yixing312/Product_engineering_design_practice/README.md

# Product_engineering_design_practice

本项目用于产品工程化设计文档的组队公用文件交流

git路径在<https://github.com/yixing312/Product_engineering_design_practice>
