yixing312/Product_engineering_design_practice/model/README.md

# Readme

本文件夹用于存放模型文件

* `model_0` 是由 mzhgg 建立的，是整个产品设计的示意图。
