yixing312/Product_engineering_design_practice/model/model_1/MG995/egrane2latonpin.SLDPRT.SLDASM

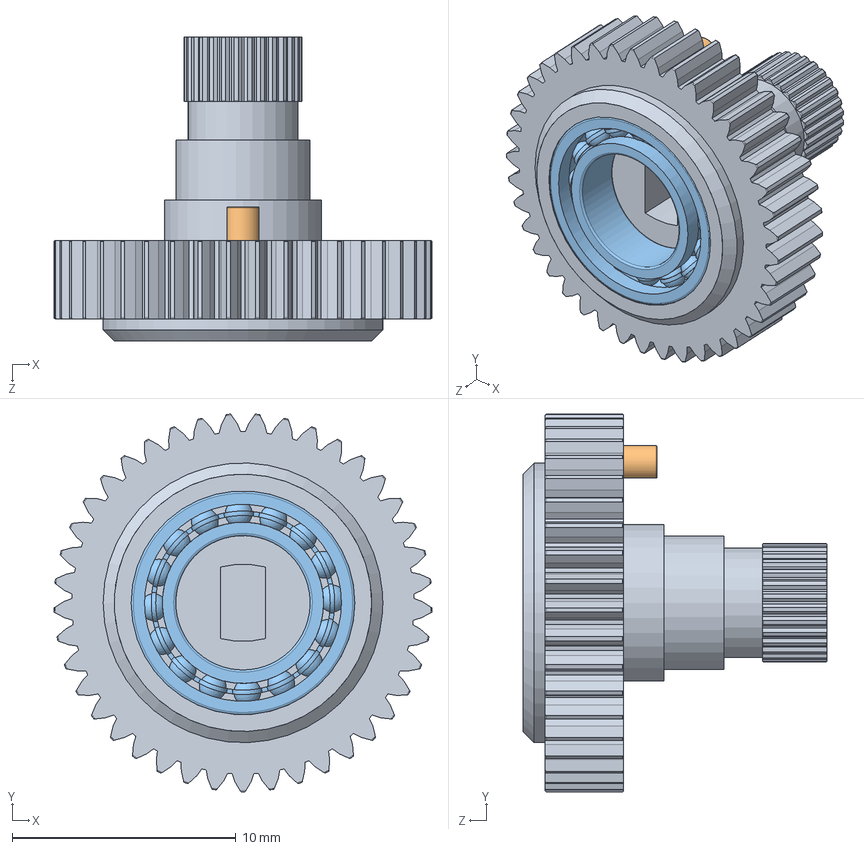
[picture p64: CAD file, 2024-06-03]
model/model_1/MG995/egrane2latonpin.SLDPRT.SLDASM
16.9 x 16.9 x 13.6 mm
otro
egrane2latonpin
radial ball bearing_68_am
