yixing312/Product_engineering_design_practice/model/model_0/MG995/egrane4aluminiolaton.SLDPRT.SLDASM

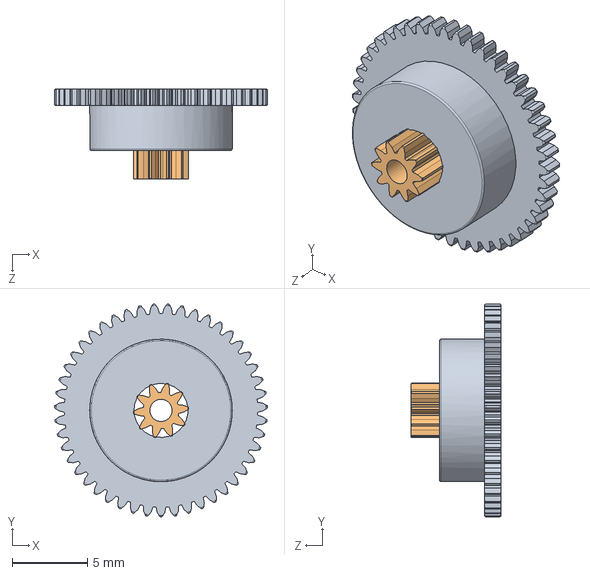
[picture p65: CAD file, 2024-05-30]
model/model_0/MG995/egrane4aluminiolaton.SLDPRT.SLDASM
14.2 x 14.2 x 6.00 mm
egrane4laton
egrane4aluminio
