yixing312/Product_engineering_design_practice/model/model_1/MG995/MG995.SLDASM

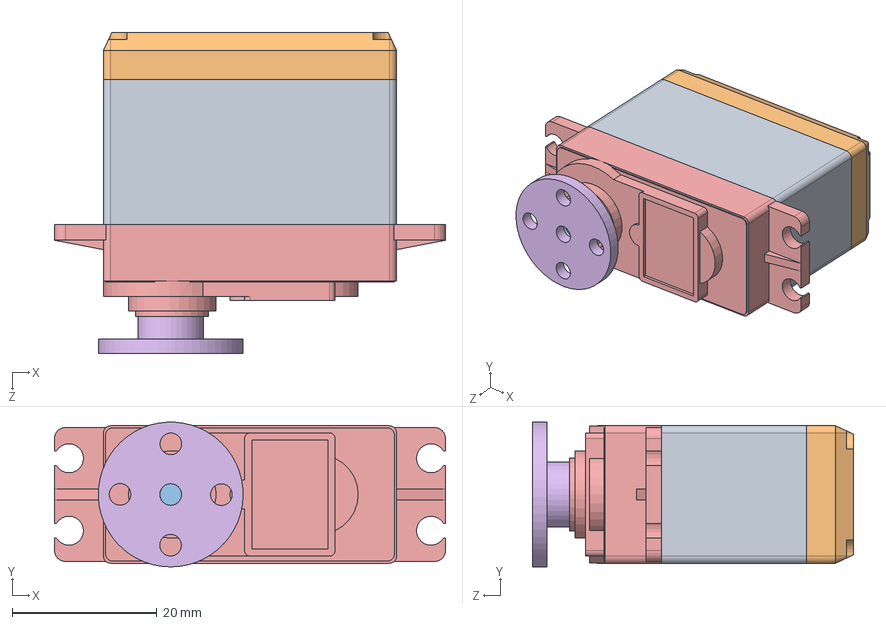
[picture p66: CAD file, 2024-06-03]
model/model_1/MG995/MG995.SLDASM
54.0 x 20.0 x 44.3 mm
centroservo
egrane3laton
egrane3aluminio
egrane4laton
egrane4aluminio
engrane2
pincorto
pinlargo
radial ball bearing_68_am x 2
baseservo
otro
egrane2latonpin
tapa servo
Bracket-Horn
