yixing312/Product_engineering_design_practice/model/model_0/MG995/egrane3aluminiolaton.SLDPRT.SLDASM

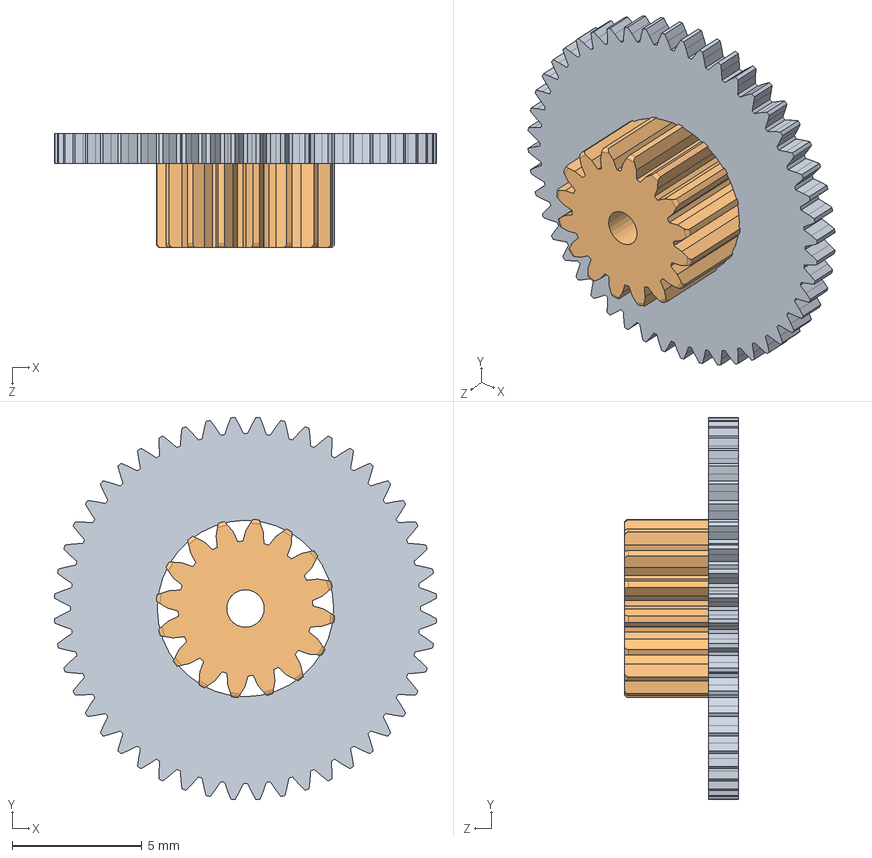
[picture p67: CAD file, 2024-05-30]
model/model_0/MG995/egrane3aluminiolaton.SLDPRT.SLDASM
14.7 x 14.7 x 4.40 mm
egrane3laton
egrane3aluminio
