yixing312/Product_engineering_design_practice/model/model_1/崭新的基座.SLDASM

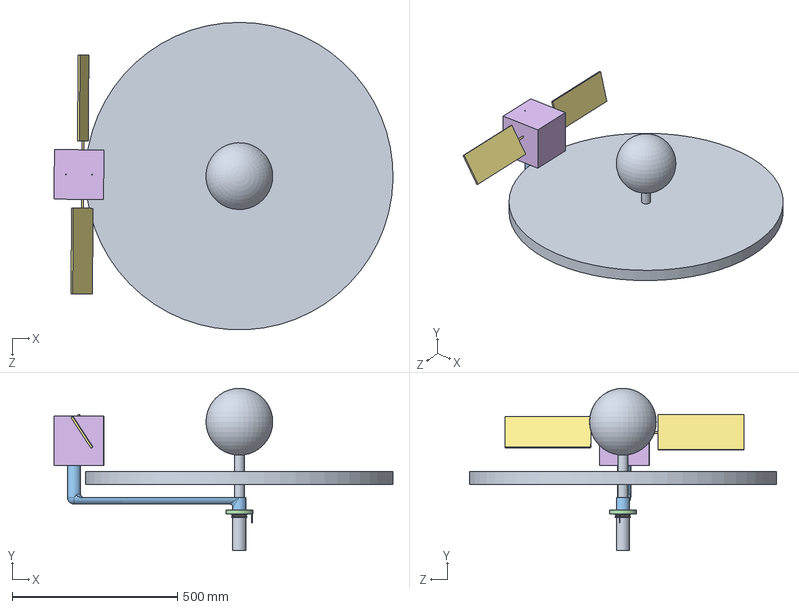
[picture p68: CAD file, 2024-06-03]
model/model_1/崭新的基座.SLDASM
1025.4 x 491.1 x 929.3 mm
地球和底座
thrust ball bearings gb
承载臂
导电滑环-假
卫星支架_舵机1连接件
centroservo
egrane3laton
egrane3aluminio
egrane4laton
egrane4aluminio
engrane2
pincorto
pinlargo
radial ball bearing_68_am x 2
baseservo
otro
egrane2latonpin
tapa servo
Bracket-Horn
舵机3_帆板
卫星本体_舵机支架3 x 2
卫星本体
帆板 x 2
