yixing312/Product_engineering_design_practice/model/model_1/MG995/tapa servorodamiento.SLDPRT.SLDASM

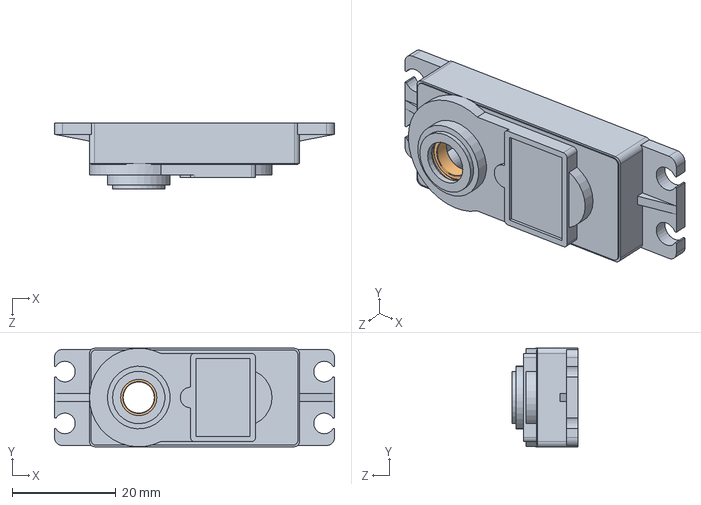
[picture p69: CAD file, 2024-05-30]
model/model_1/MG995/tapa servorodamiento.SLDPRT.SLDASM
54.0 x 19.0 x 12.8 mm
tapa servo
radial ball bearing_68_am
