yixing312/Product_engineering_design_practice/model/model_0/Assembly.SLDASM

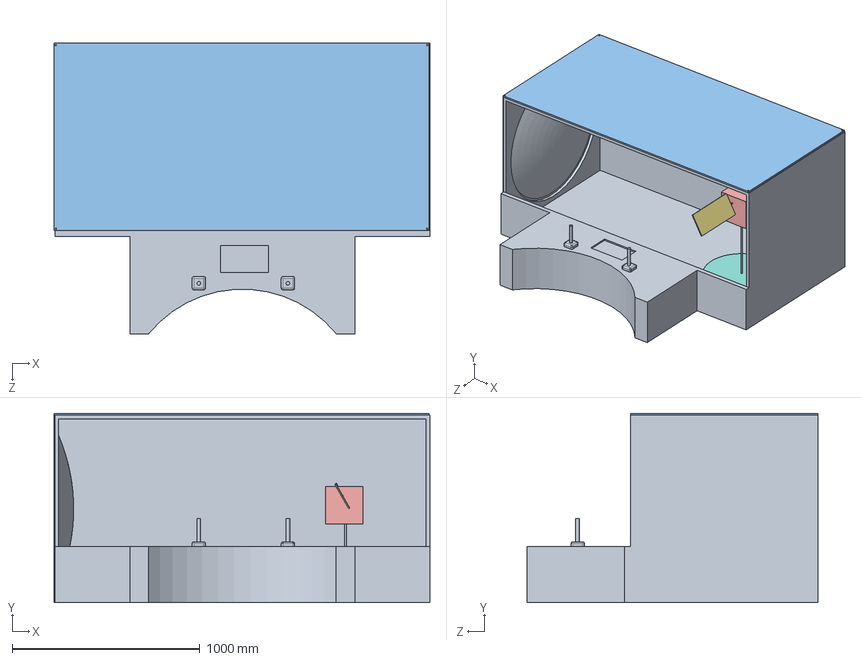
[picture p72: CAD file, 2024-05-30]
model/model_0/Assembly.SLDASM
2005.0 x 1010.0 x 1550.0 mm
centroservo x 3
egrane3laton x 3
egrane3aluminio x 3
egrane4laton x 3
egrane4aluminio x 3
engrane2 x 3
pincorto x 3
pinlargo x 3
radial ball bearing_68_am x 6
baseservo x 3
otro x 3
egrane2latonpin x 3
tapa servo x 3
Bracket-Horn x 3
卫星支架
卫星支架_舵机1连接件
卫星支架_舵机2
卫星支架_舵机3
舵机3_帆板
卫星本体
卫星本体_舵机支架3 x 2
帆板 x 2
light plat
plate
raspberrypi
