yixing312/Product_engineering_design_practice/model/model_0/MG995/egrane2latonpin.SLDPRT

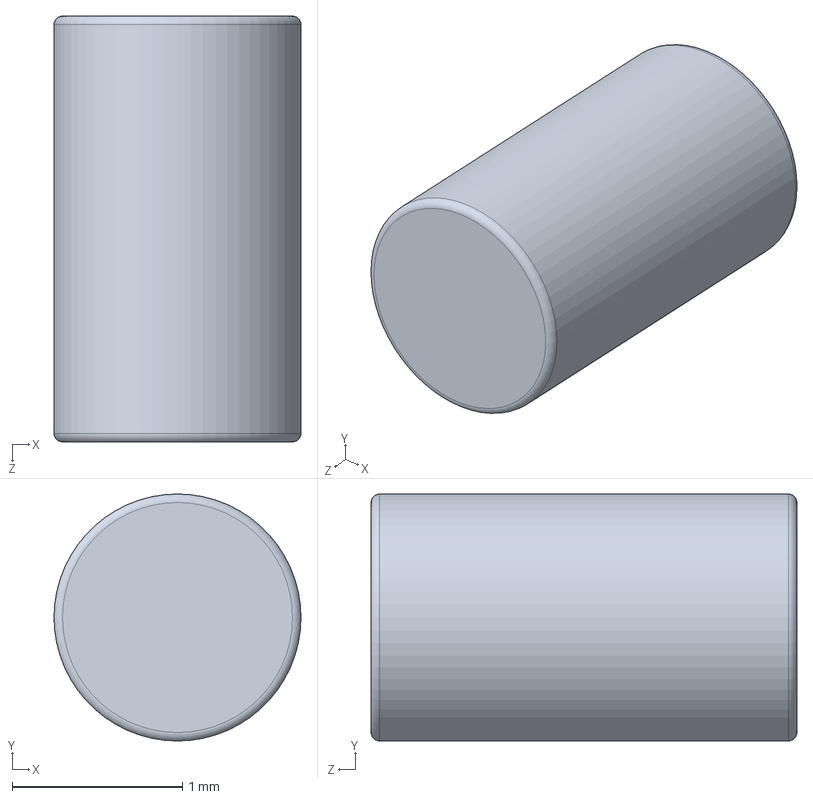
[picture p73: CAD file, 2024-05-30]
model/model_0/MG995/egrane2latonpin.SLDPRT
1.45 x 1.45 x 2.50 mm
