yixing312/Product_engineering_design_practice/model/model_1/承载臂.SLDPRT

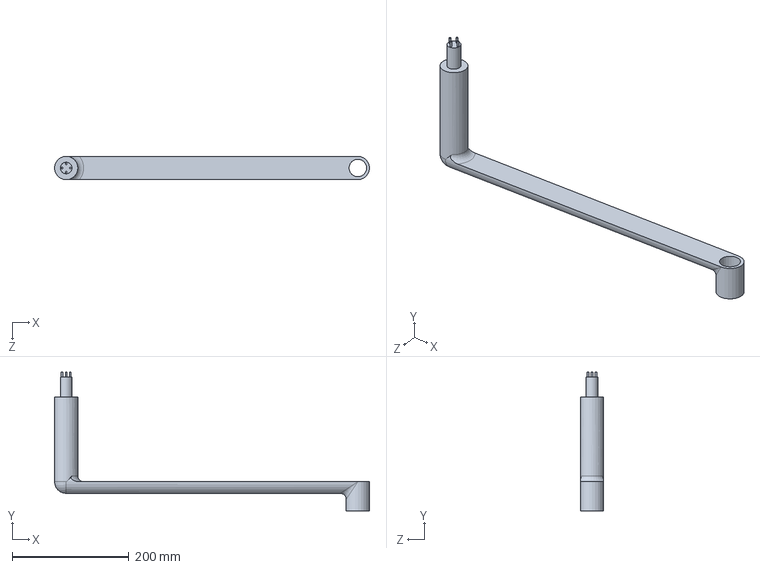
[picture p75: CAD file, 2024-06-03]
model/model_1/承载臂.SLDPRT
540.0 x 238.0 x 40.1 mm
