yixing312/Product_engineering_design_practice/model/model_0/light plat.SLDPRT

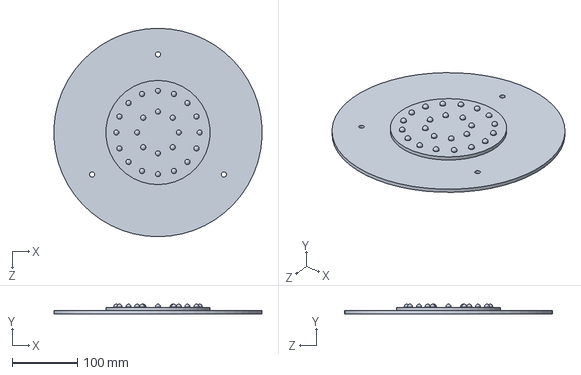
[picture p76: CAD file, 2024-05-30]
model/model_0/light plat.SLDPRT
319.5 x 15.0 x 320.0 mm
