yixing312/Product_engineering_design_practice/model/model_1/导电滑环-假.SLDPRT

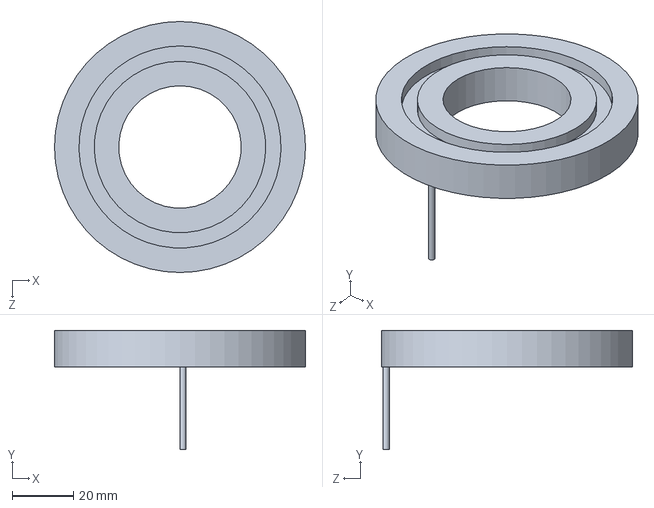
[picture p77: CAD file, 2024-06-03]
model/model_1/导电滑环-假.SLDPRT
82.0 x 39.0 x 82.0 mm
