yixing312/Product_engineering_design_practice/drawing/卫星部分.DXF

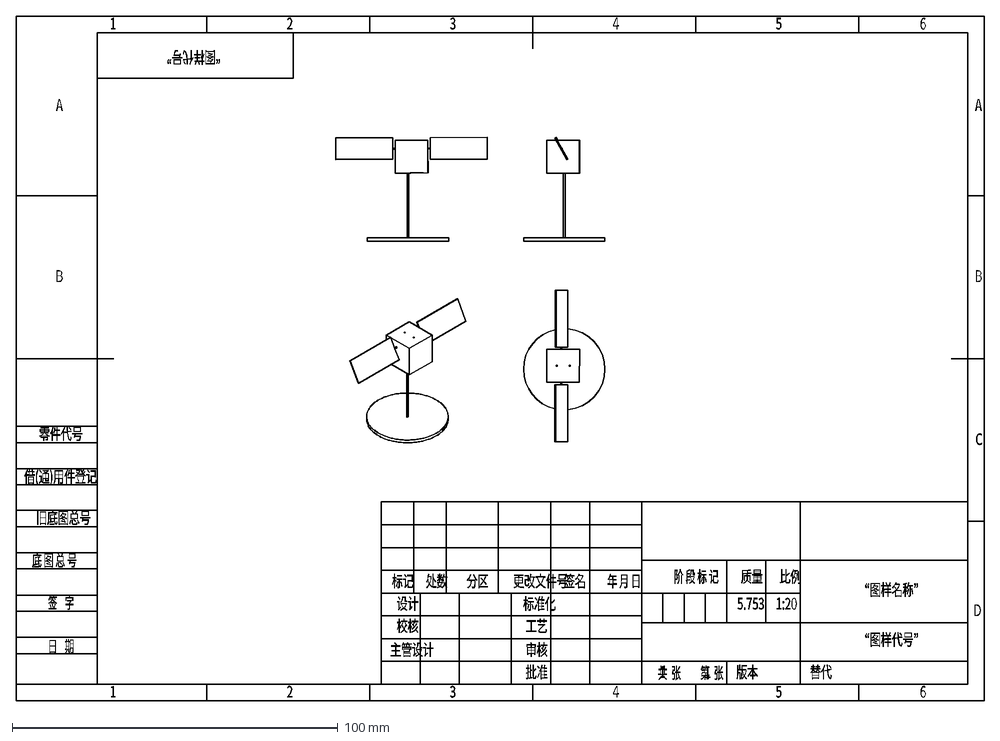
[picture p78: CAD file, 2024-05-31]
drawing/卫星部分.DXF
“图样代号”
替代
版本
审核
工艺
比例
质量
第 张
共 张
阶 段 标 记
批准
标准化
主管设计
年 月 日
签名
更改文件号
分区
处数
标记
设计
校核
零件代号
借(通)用件登记
旧底图总号
底 图 总 号
日 期
“图样名称”
5.753
1
1:20
B
A
D
C
签 字
2
5
4
3
6
