yixing312/Product_engineering_design_practice/model/model_0/舵机3_帆板.SLDPRT

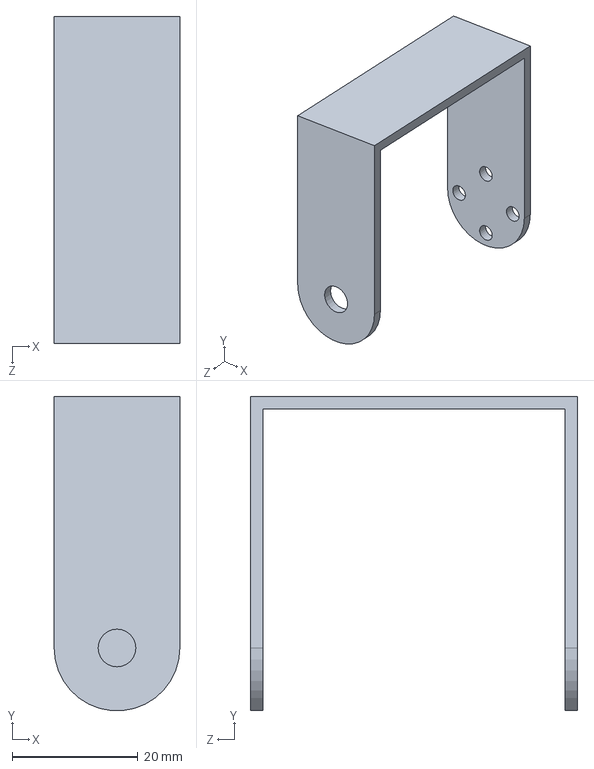
[picture p79: CAD file, 2024-05-30]
model/model_0/舵机3_帆板.SLDPRT
20.0 x 50.0 x 52.0 mm
