yixing312/Product_engineering_design_practice/model/model_1/MG995/pinlargo.SLDPRT

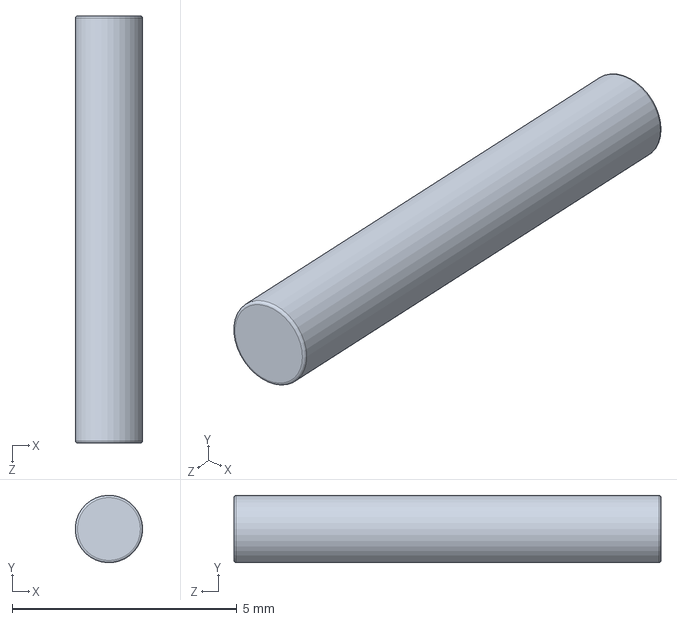
[picture p80: CAD file, 2024-05-30]
model/model_1/MG995/pinlargo.SLDPRT
1.50 x 1.50 x 9.50 mm
