yixing312/Product_engineering_design_practice/model/model_1/地球和底座.SLDPRT

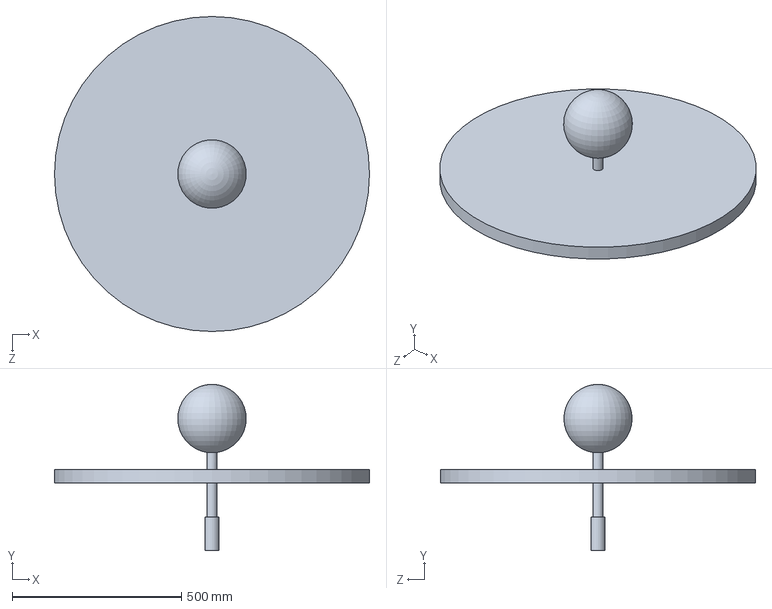
[picture p81: CAD file, 2024-06-03]
model/model_1/地球和底座.SLDPRT
930.0 x 491.1 x 930.0 mm
