yixing312/Product_engineering_design_practice/model/model_0/satellite.SLDPRT

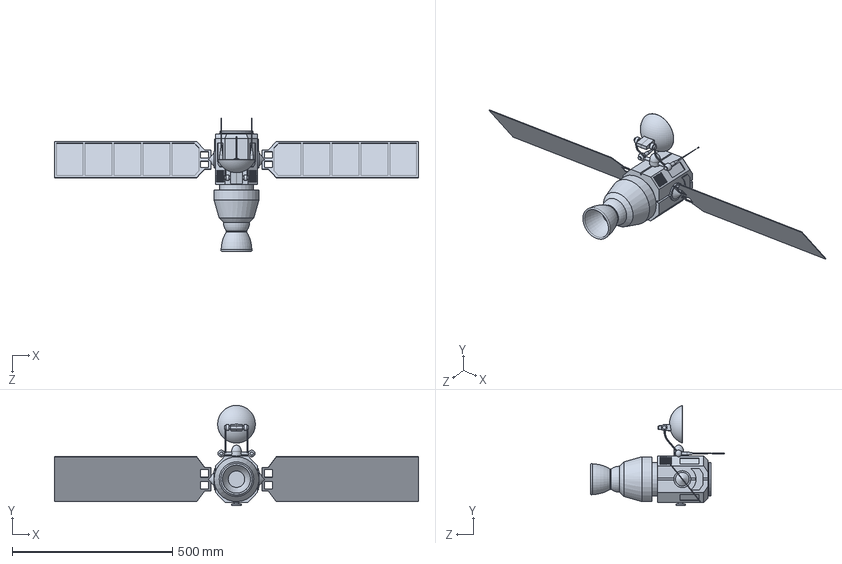
[picture p82: CAD file, 2024-05-30]
model/model_0/satellite.SLDPRT
1134.7 x 312.6 x 416.3 mm
