yixing312/Product_engineering_design_practice/model/model_1/MG995/egrane3aluminio.SLDPRT

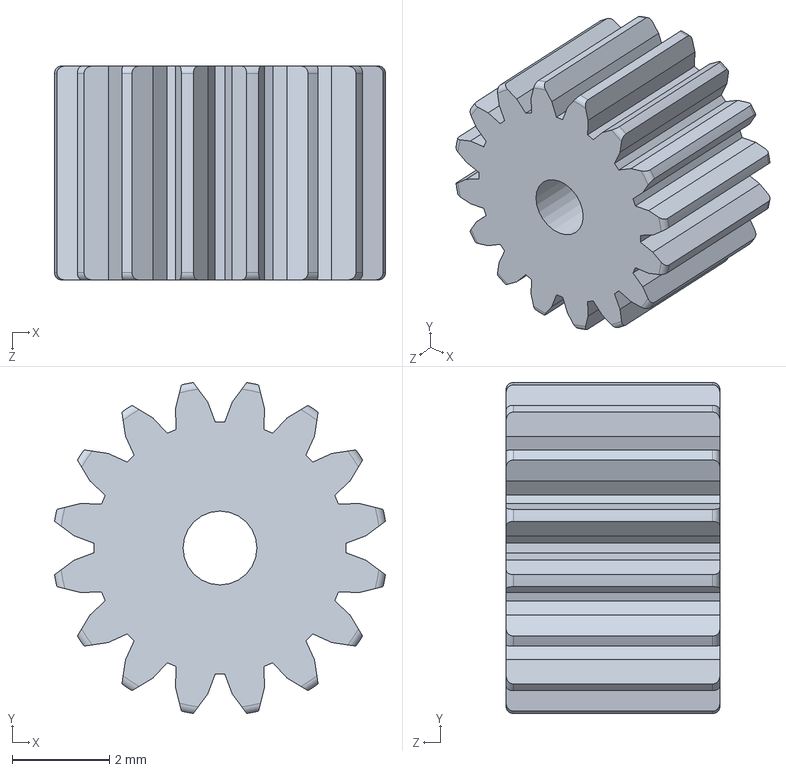
[picture p83: CAD file, 2024-05-30]
model/model_1/MG995/egrane3aluminio.SLDPRT
6.81 x 6.81 x 4.40 mm
