yixing312/Product_engineering_design_practice/model/model_1/帆板.SLDPRT

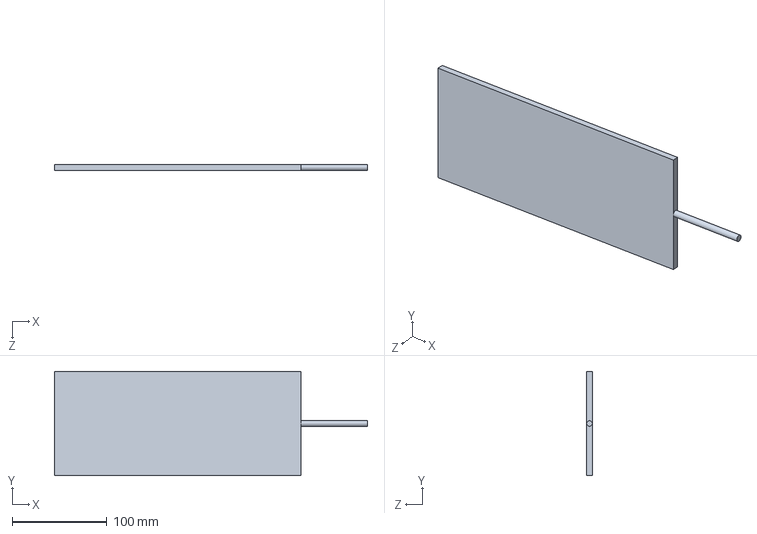
[picture p84: CAD file, 2024-06-03]
model/model_1/帆板.SLDPRT
330.0 x 110.0 x 6.00 mm
