yixing312/Product_engineering_design_practice/model/model_0/MG995/centroservo.SLDPRT

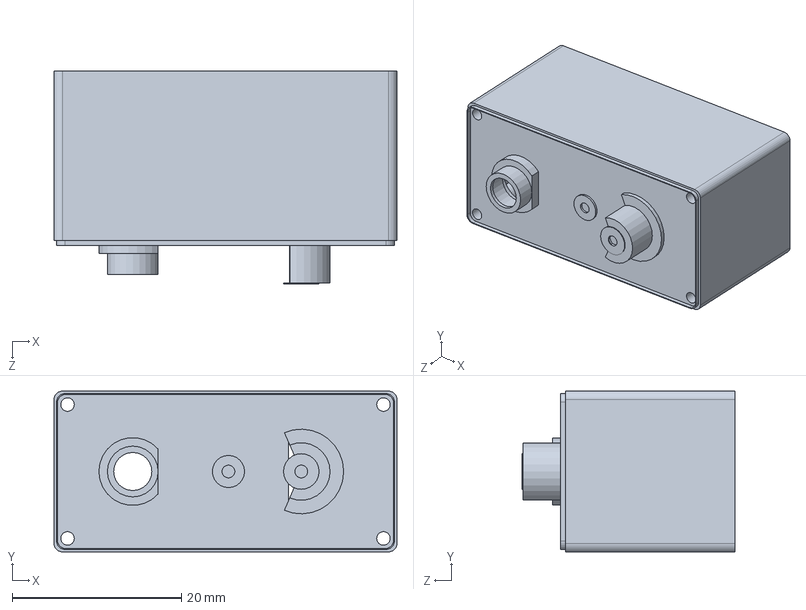
[picture p85: CAD file, 2024-05-30]
model/model_0/MG995/centroservo.SLDPRT
40.5 x 19.0 x 25.1 mm
