yixing312/Product_engineering_design_practice/model/model_0/卫星支架_舵机2.SLDPRT

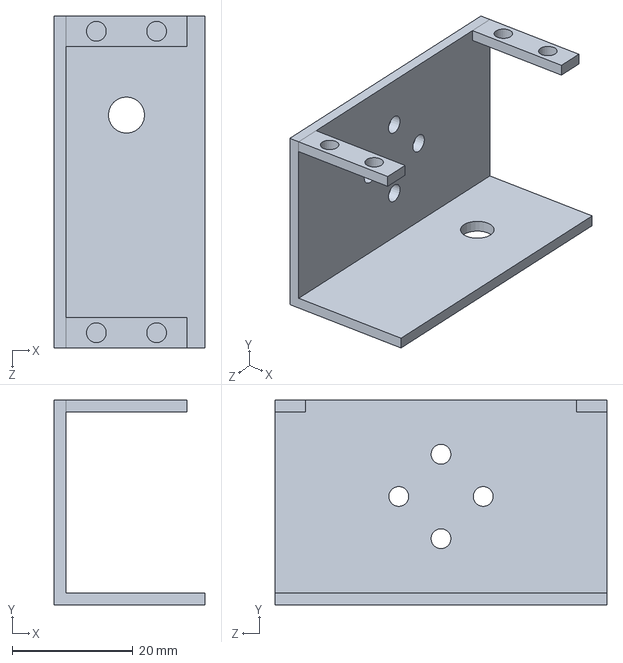
[picture p86: CAD file, 2024-05-30]
model/model_0/卫星支架_舵机2.SLDPRT
25.0 x 34.0 x 55.0 mm
