yixing312/Product_engineering_design_practice/model/model_1/MG995/engrane2.SLDPRT

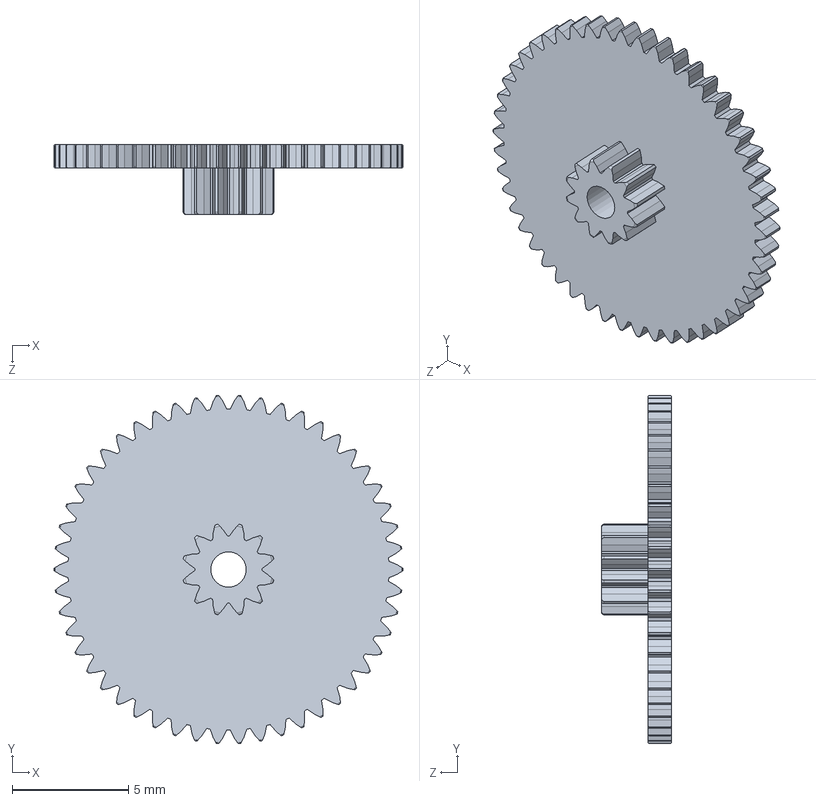
[picture p87: CAD file, 2024-05-30]
model/model_1/MG995/engrane2.SLDPRT
15.0 x 15.0 x 3.00 mm
