yixing312/Product_engineering_design_practice/model/model_0/MG995/egrane4laton.SLDPRT

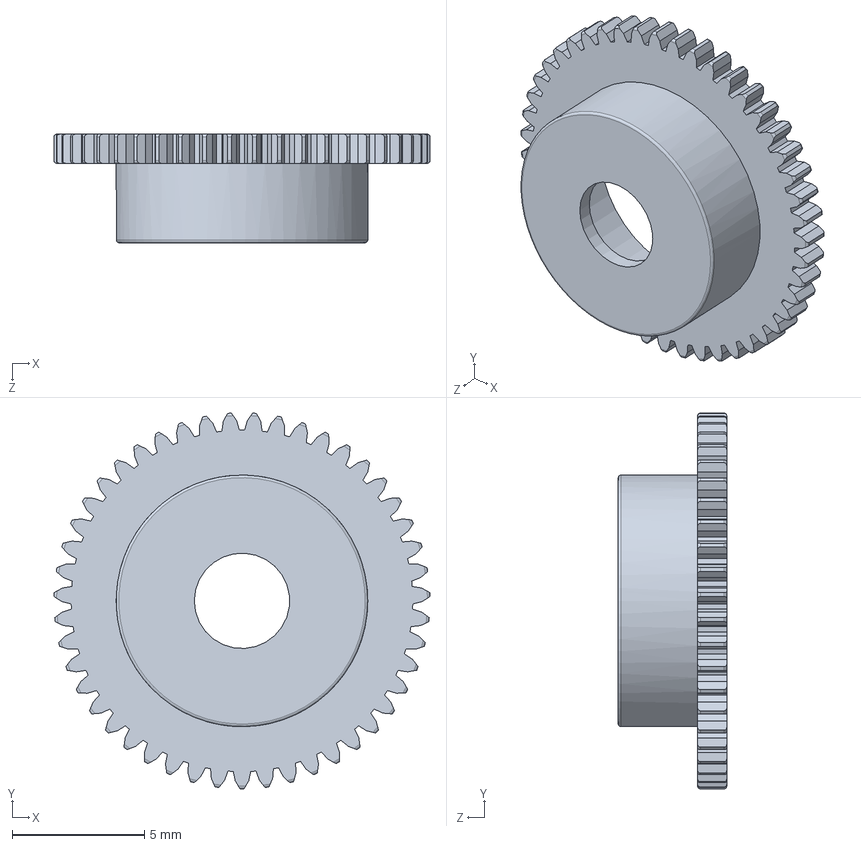
[picture p88: CAD file, 2024-05-30]
model/model_0/MG995/egrane4laton.SLDPRT
14.2 x 14.2 x 4.10 mm
