yixing312/Product_engineering_design_practice/model/model_1/MG995/Bracket-Horn.SLDPRT

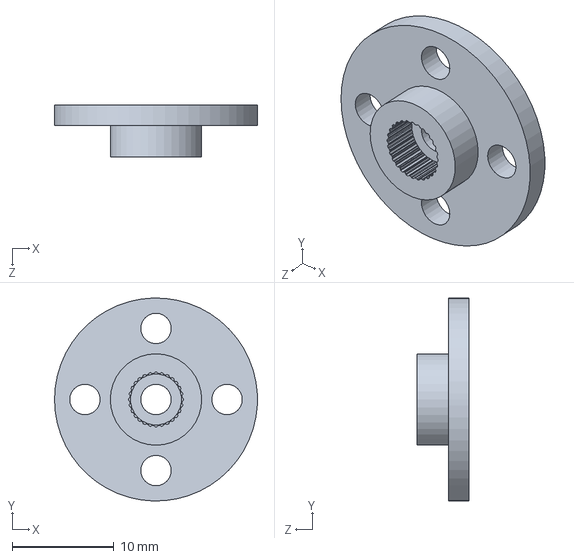
[picture p89: CAD file, 2024-05-30]
model/model_1/MG995/Bracket-Horn.SLDPRT
20.0 x 20.0 x 5.10 mm
