yixing312/Product_engineering_design_practice/model/model_1/卫星本体.SLDPRT

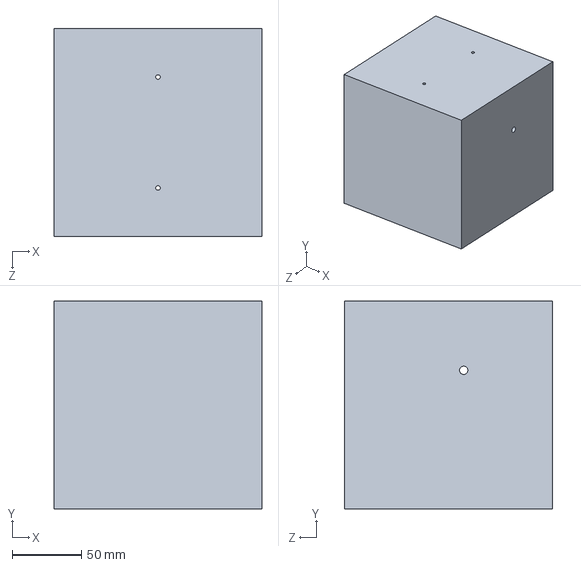
[picture p90: CAD file, 2024-06-03]
model/model_1/卫星本体.SLDPRT
150.0 x 150.0 x 150.0 mm
