yixing312/Product_engineering_design_practice/model/model_0/卫星本体_舵机支架3.SLDPRT

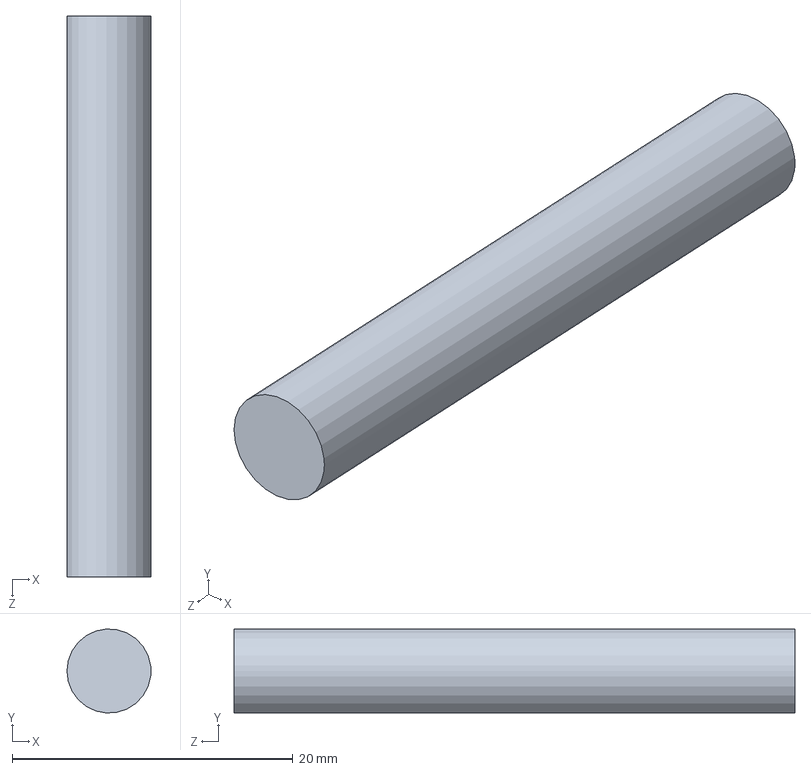
[picture p91: CAD file, 2024-05-30]
model/model_0/卫星本体_舵机支架3.SLDPRT
6.00 x 5.99 x 40.0 mm
