yixing312/Product_engineering_design_practice/model/model_1/舵机3_帆板.SLDPRT

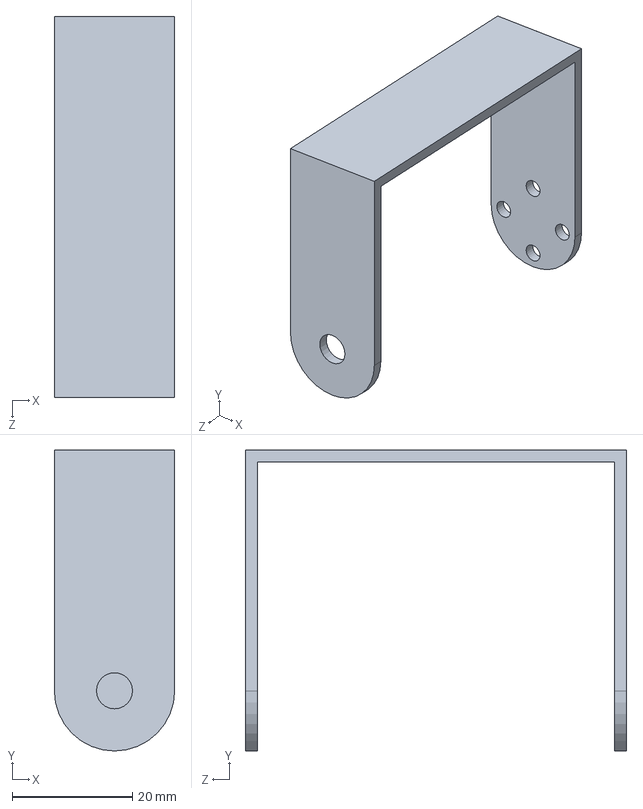
[picture p92: CAD file, 2024-06-03]
model/model_1/舵机3_帆板.SLDPRT
20.0 x 50.0 x 63.3 mm
