yixing312/Product_engineering_design_practice/model/model_0/hidden plain.SLDPRT

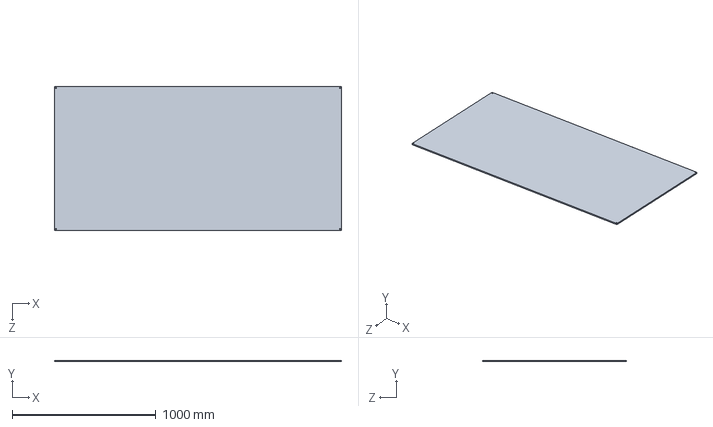
[picture p93: CAD file, 2024-05-30]
model/model_0/hidden plain.SLDPRT
2000.0 x 10.0 x 1000.0 mm
