yixing312/Product_engineering_design_practice/model/model_1/卫星本体_舵机支架3.SLDPRT

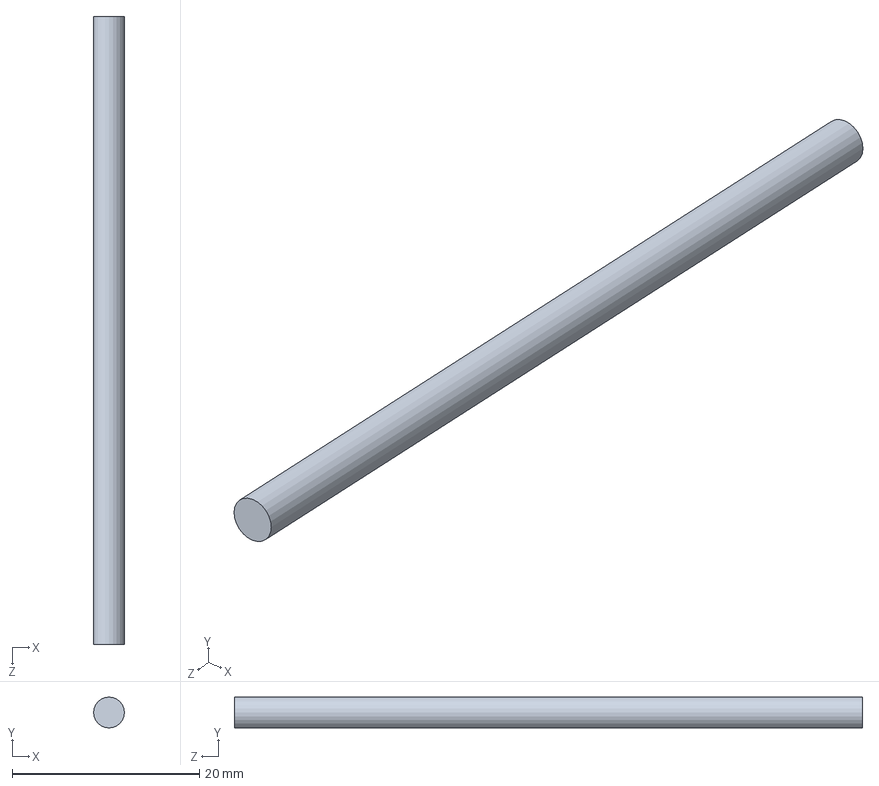
[picture p94: CAD file, 2024-06-03]
model/model_1/卫星本体_舵机支架3.SLDPRT
3.30 x 3.30 x 67.1 mm
