yixing312/Product_engineering_design_practice/model/model_0/卫星支架.SLDPRT

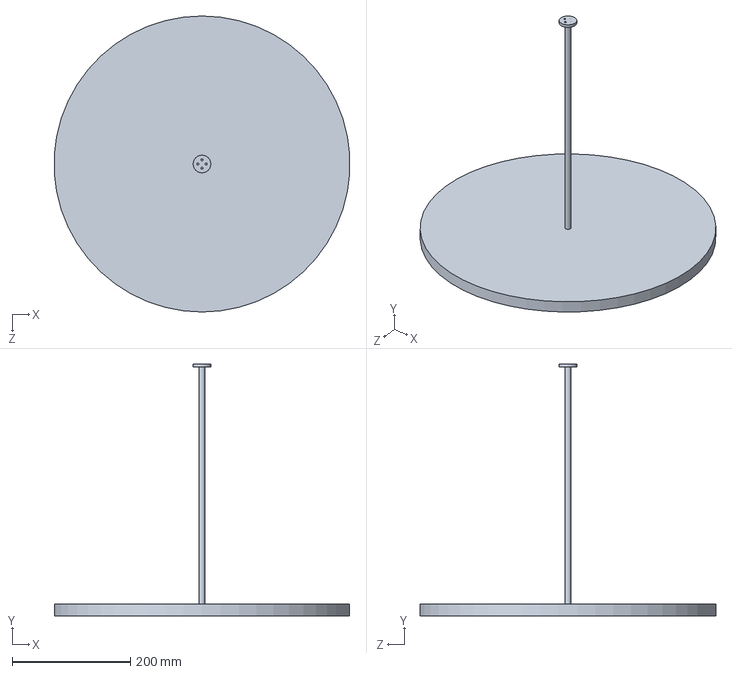
[picture p95: CAD file, 2024-05-30]
model/model_0/卫星支架.SLDPRT
499.0 x 425.0 x 500.0 mm
