yixing312/Product_engineering_design_practice/model/model_1/卫星支架_舵机1连接件.SLDPRT

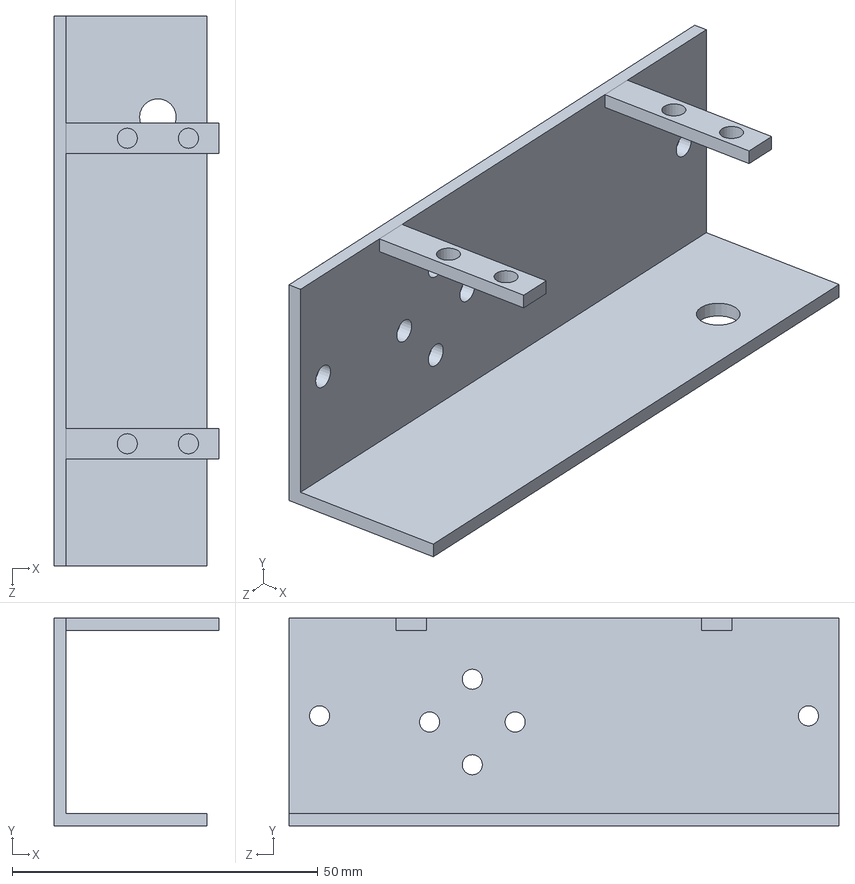
[picture p96: CAD file, 2024-06-03]
model/model_1/卫星支架_舵机1连接件.SLDPRT
27.0 x 34.0 x 90.0 mm
