yixing312/Product_engineering_design_practice/model/model_0/MG995/egrane4aluminio.SLDPRT

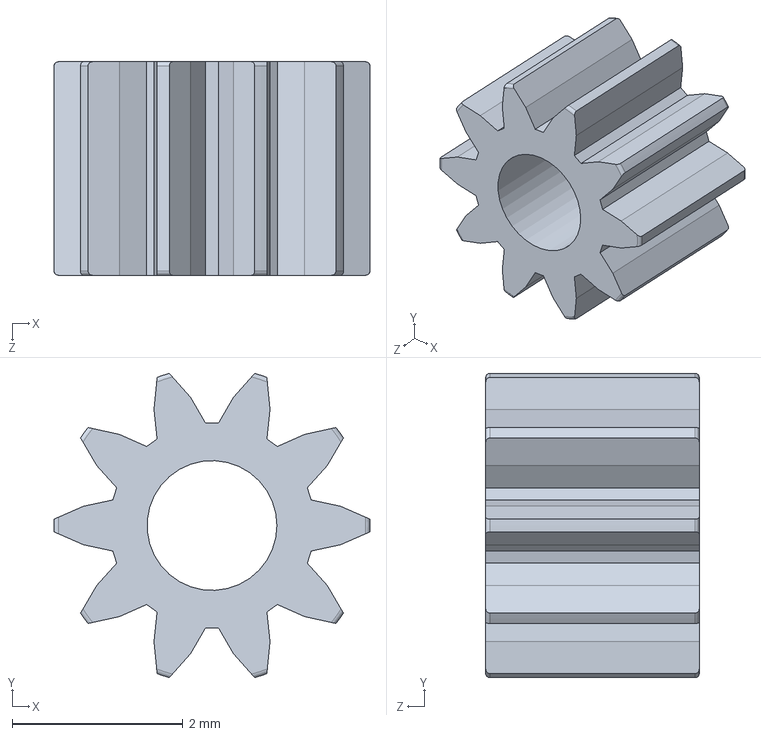
[picture p97: CAD file, 2024-05-30]
model/model_0/MG995/egrane4aluminio.SLDPRT
3.70 x 3.56 x 2.50 mm
