yixing312/Product_engineering_design_practice/model/model_1/MG995/tapa servo.SLDPRT

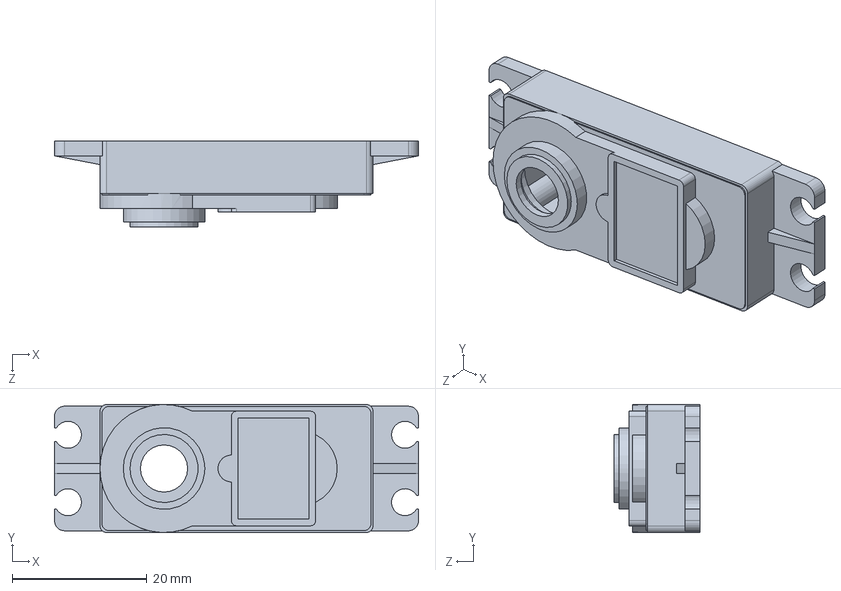
[picture p98: CAD file, 2024-05-30]
model/model_1/MG995/tapa servo.SLDPRT
54.0 x 19.0 x 12.8 mm
