yixing312/Product_engineering_design_practice/model/model_0/MG995/egrane3laton.SLDPRT

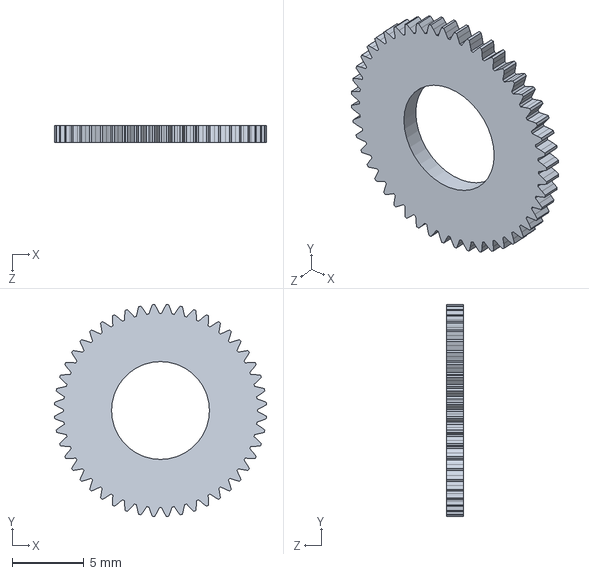
[picture p99: CAD file, 2024-05-30]
model/model_0/MG995/egrane3laton.SLDPRT
14.7 x 14.7 x 1.15 mm
