yixing312/Product_engineering_design_practice/model/model_0/Framework.SLDPRT

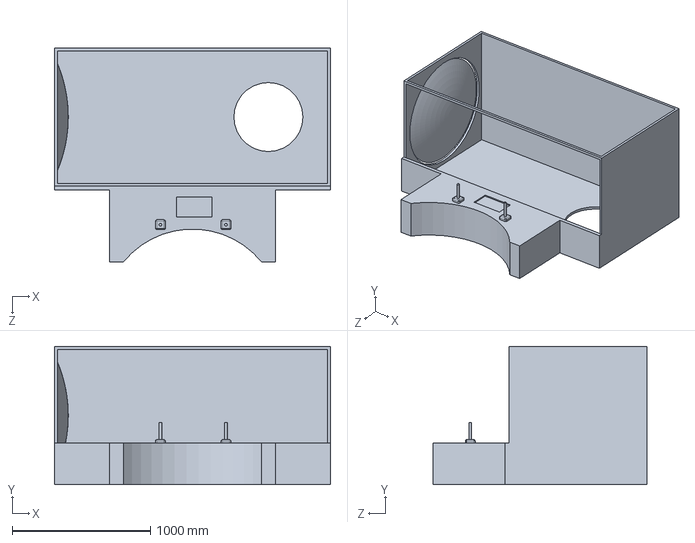
[picture p100: CAD file, 2024-05-30]
model/model_0/Framework.SLDPRT
2000.0 x 1000.0 x 1550.0 mm
