yixing312/Product_engineering_design_practice/model/model_0/plate.SLDPRT

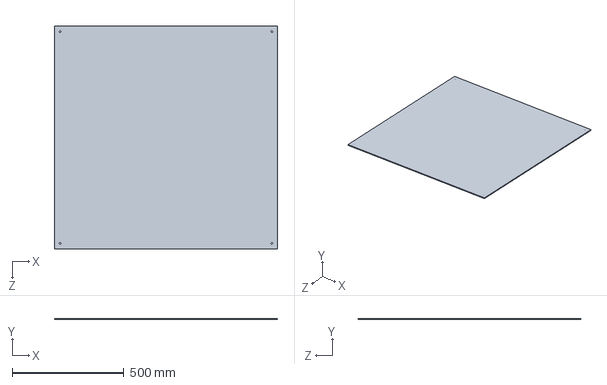
[picture p101: CAD file, 2024-05-30]
model/model_0/plate.SLDPRT
1000.0 x 5.00 x 1000.0 mm
