yixing312/Product_engineering_design_practice/model/model_1/MG995/otro.SLDPRT

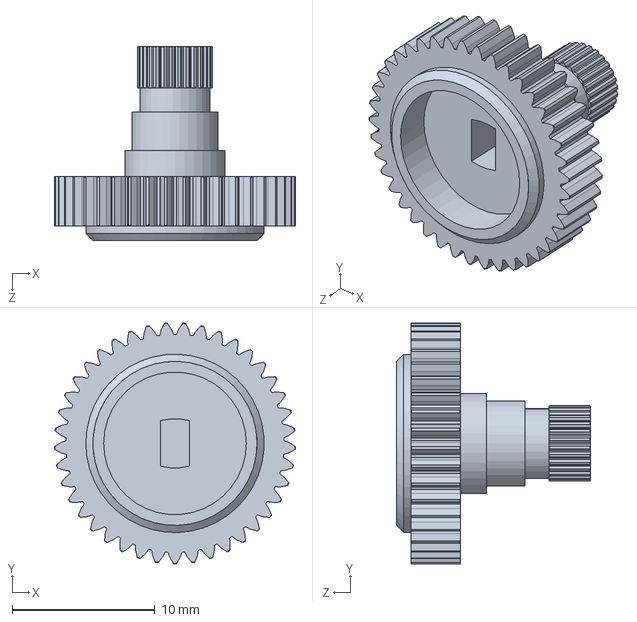
[picture p102: CAD file, 2024-05-30]
model/model_1/MG995/otro.SLDPRT
16.9 x 16.9 x 13.6 mm
