yixing312/Product_engineering_design_practice/model/model_0/卫星本体.SLDPRT

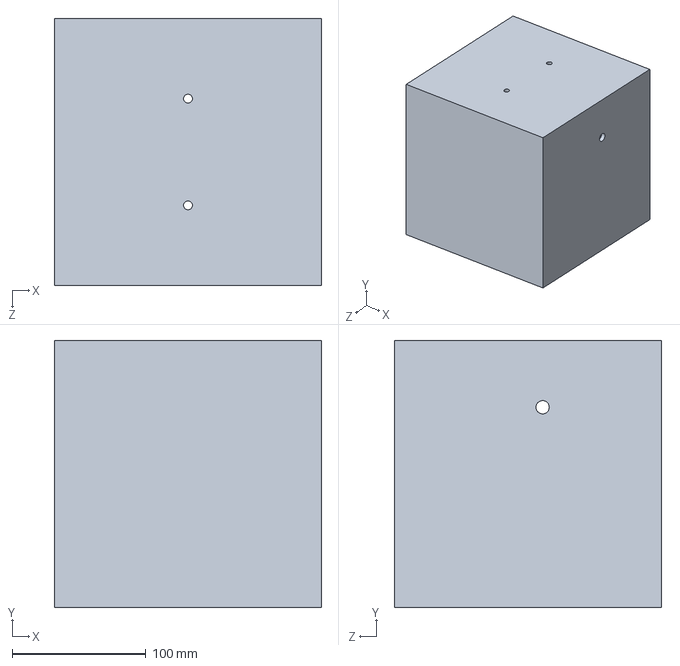
[picture p103: CAD file, 2024-05-30]
model/model_0/卫星本体.SLDPRT
200.0 x 200.0 x 200.0 mm
