yixing312/Product_engineering_design_practice/model/model_1/MG995/bracket.SLDPRT

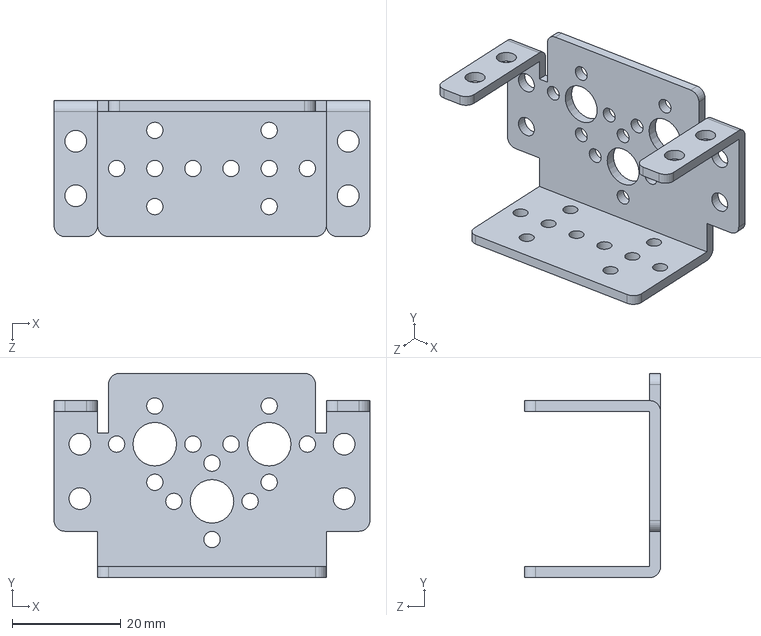
[picture p104: CAD file, 2024-05-30]
model/model_1/MG995/bracket.SLDPRT
58.0 x 37.5 x 25.0 mm
