yixing312/Product_engineering_design_practice/model/model_0/MG995/pincorto.SLDPRT

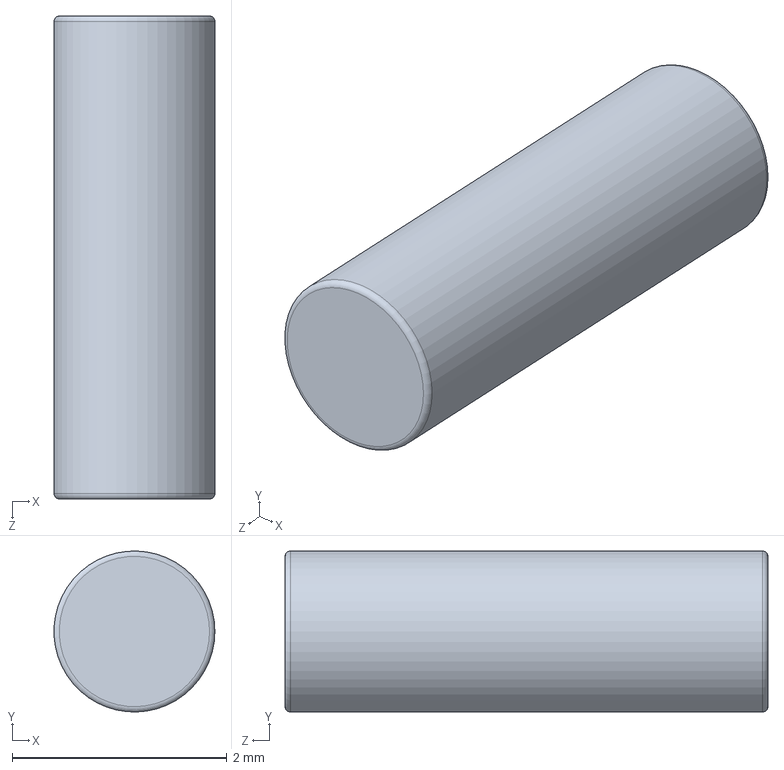
[picture p105: CAD file, 2024-05-30]
model/model_0/MG995/pincorto.SLDPRT
1.50 x 1.50 x 4.50 mm
