yixing312/Product_engineering_design_practice/model/model_0/raspberrypi.SLDPRT

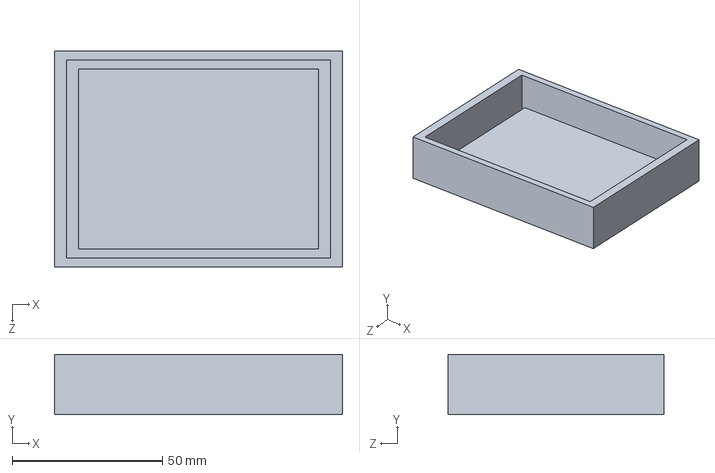
[picture p106: CAD file, 2024-05-30]
model/model_0/raspberrypi.SLDPRT
96.0 x 20.0 x 72.0 mm
