yixing312/Product_engineering_design_practice/model/model_0/MG995/baseservo.SLDPRT

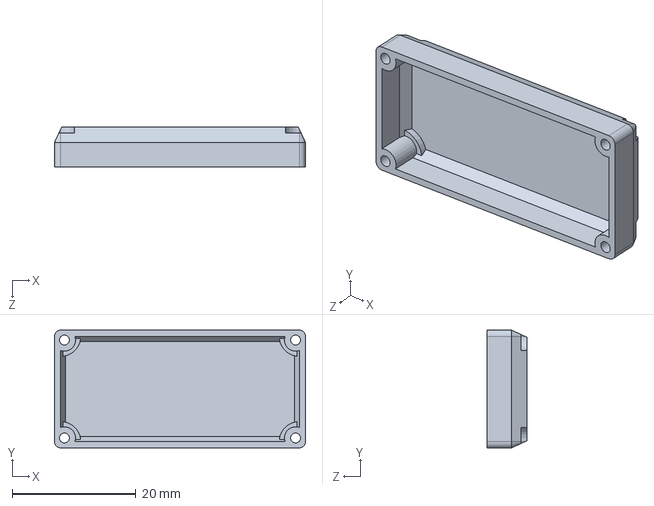
[picture p107: CAD file, 2024-05-30]
model/model_0/MG995/baseservo.SLDPRT
40.5 x 19.0 x 6.50 mm
