yixing312/Product_engineering_design_practice/model/model_0/卫星支架_舵机3.SLDPRT

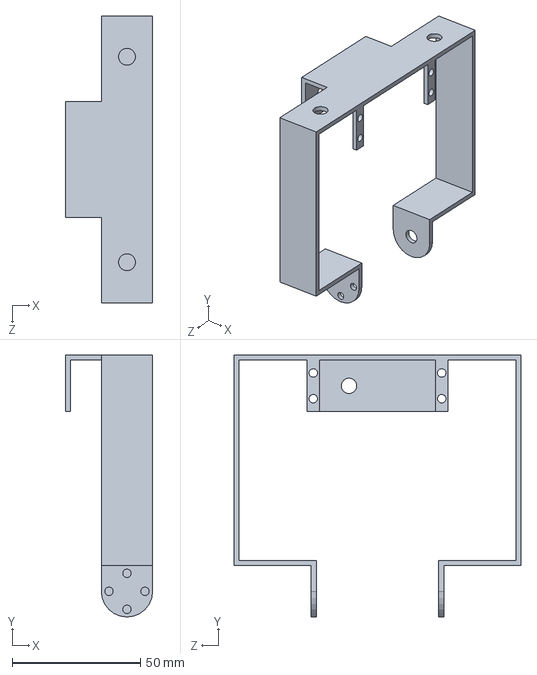
[picture p108: CAD file, 2024-05-30]
model/model_0/卫星支架_舵机3.SLDPRT
34.0 x 102.0 x 111.7 mm
