yixing312/Product_engineering_design_practice/model/model_0/帆板.SLDPRT

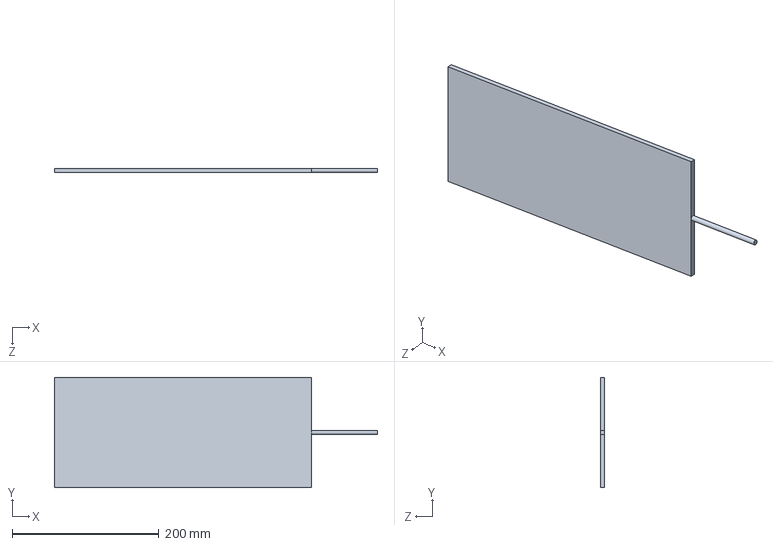
[picture p109: CAD file, 2024-05-30]
model/model_0/帆板.SLDPRT
440.0 x 150.0 x 6.00 mm
