yixing312/Product_engineering_design_practice/(list of files, cad)

Other CAD files:
model/model_0/MG995/MG995.SLDASM
model/model_0/MG995/egrane2latonpin.SLDPRT.SLDASM
drawing/装配展开图.dwg
drawing/整体设计展示.dwg
drawing/整体设计展示A3.dwg
drawing/卫星部分-without.dwg
model/model_0/卫星支架_舵机1连接件.SLDPRT
model/model_1/MG995/egrane2laton.SLDPRT
drawing/卫星部分.dwg
model/Diagram/整体设计展示.dwg
model/Diagram/装配展开图.dwg
model/model_0/卫星部分-without.SLDDRW
model/model_0/卫星部分.SLDDRW
