yixing312/Product_engineering_design_practice/(commit log)

2024-05-30 第一次提交，关于zhgg的建模文件
    [Assembly.SLDASM, Bracket-Horn.SLDPRT, Framework.SLDPRT, MG995.SLDASM, baseservo.SLDPRT, bracket.SLDPRT, centroservo.SLDPRT, egrane2laton.SLDPRT]
2024-05-30 之前的产品设计说明书
2024-05-31 doc 20240530
    [整体设计展示.dwg, 装配展开图.dwg]
2024-05-31 新增的图纸文件
    [Assembly.SLDASM, Bracket-Horn.SLDPRT, MG995.SLDASM, baseservo.SLDPRT, centroservo.SLDPRT, egrane2latonpin.SLDPRT, egrane2latonpin.SLDPRT.SLDASM, egrane3aluminio.SLDPRT]
2024-05-31 reference report and model_1
    [BottomPlain.SLDPRT, VerticalBeam.SLDPRT]
